VX7FAR/Servo-Tester/CAD/enclosure.step

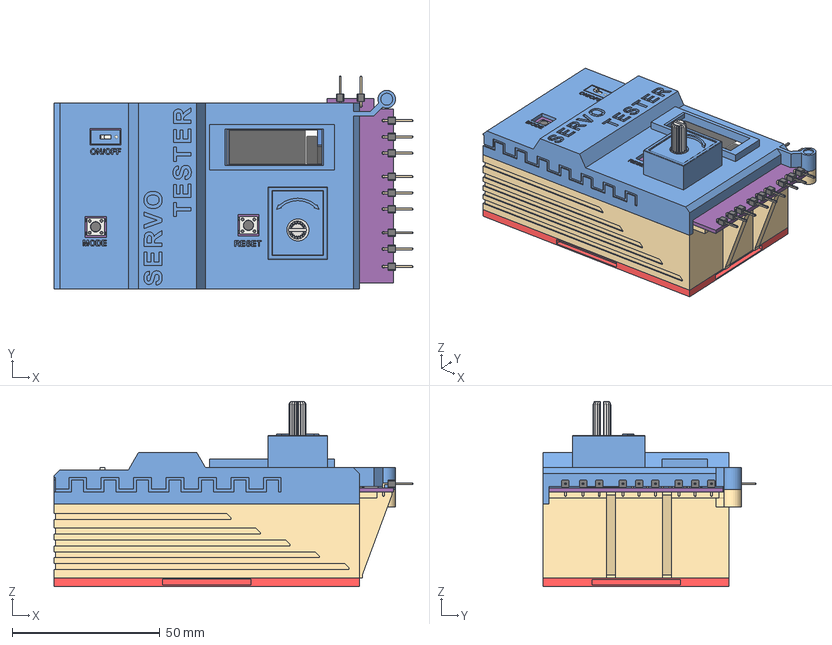
[picture p7: CAD file, 2026-10-06]
CAD/enclosure.step
121.7 x 72.0 x 62.8 mm
PinHeader_1x01_P254mm_Horizontal x 11
Arduino Nano_1
shaft
ScrewBase
Board
Pin1
Pin2
Pin3
casing
D_A-405_P10.16mm_Horizontal_2 x 2
SW_PUSH_6mm_2 x 2
OLED_0.91_128x32_2
Pin Header 4 x 1 TH 2.54mm Pitch
RESC-0603 x 13
2SD0601A
SW_DIP_SPSTx01_Slide_978x472mm_W762mm_P254mm
serC964_PCB
