VX7FAR/Servo-Tester/PCB/servo tester.step

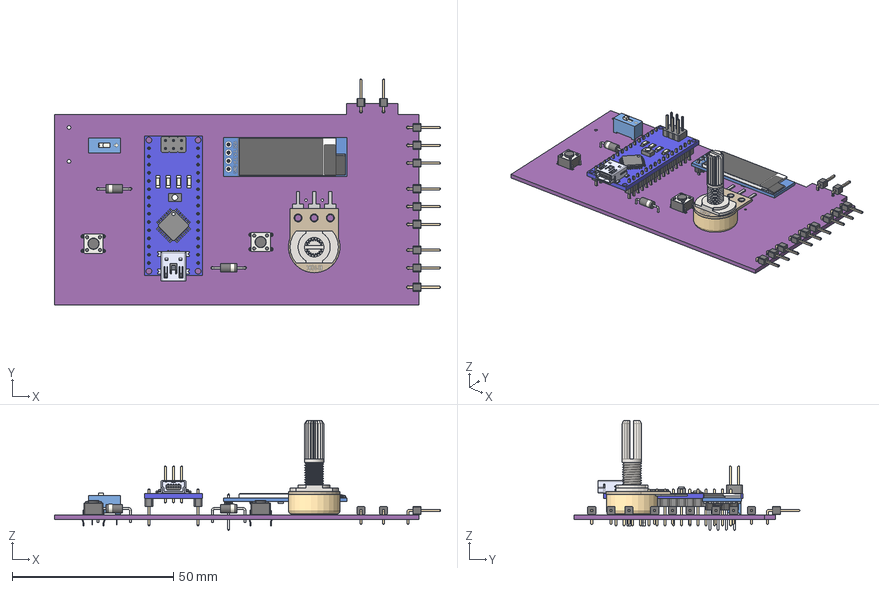
[picture p8: CAD file, 2026-09-28]
PCB/servo tester.step
119.7 x 70.0 x 34.1 mm
PinHeader_1x01_P254mm_Horizontal x 11
Arduino Nano
Shaft
ScrewBase
Board
Pin1
Pin2
Pin3
Casing
D_A-405_P10.16mm_Horizontal x 2
SW_PUSH_6mm x 2
OLED_0.91_128x32
Pin Header 4 x 1 TH 2.54mm Pitch
RESC-0603 x 13
2SD0601A
SW_DIP_SPSTx01_Slide_978x472mm_W762mm_P254mm
serC964_PCB
