VX7FAR/Servo-Tester/assets/Arduino Nano.STEP

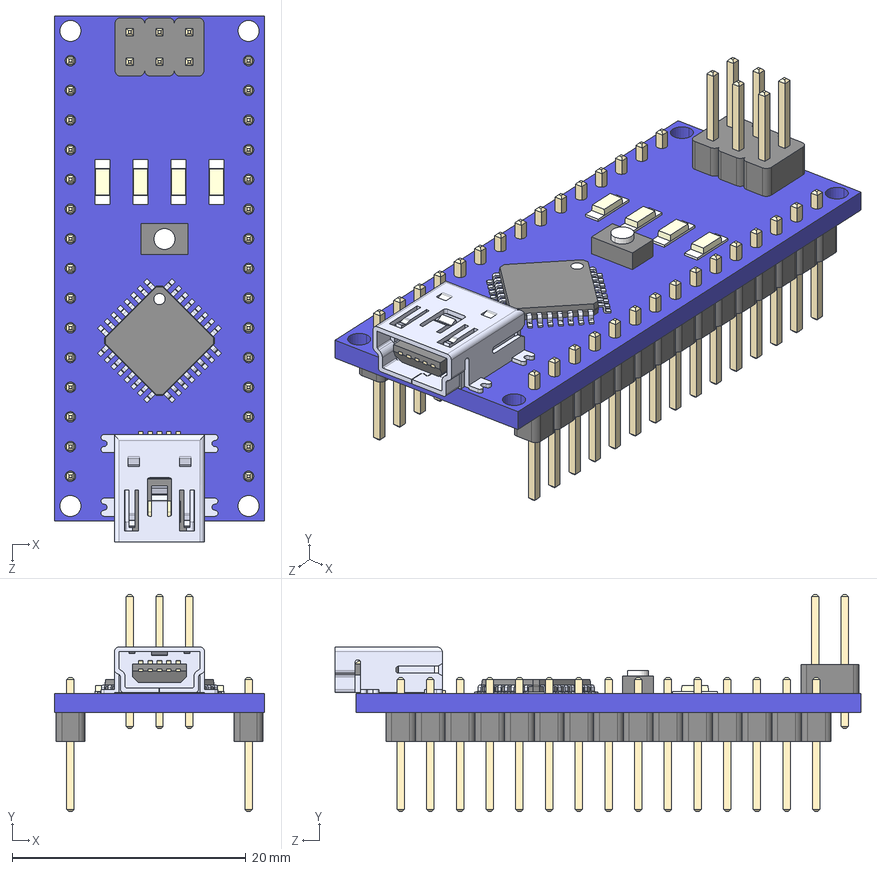
[picture p9: CAD file, 2026-09-20]
assets/Arduino Nano.STEP
18.0 x 18.6 x 45.0 mm
