VX7FAR/Servo-Tester/CAD/PANEL.step

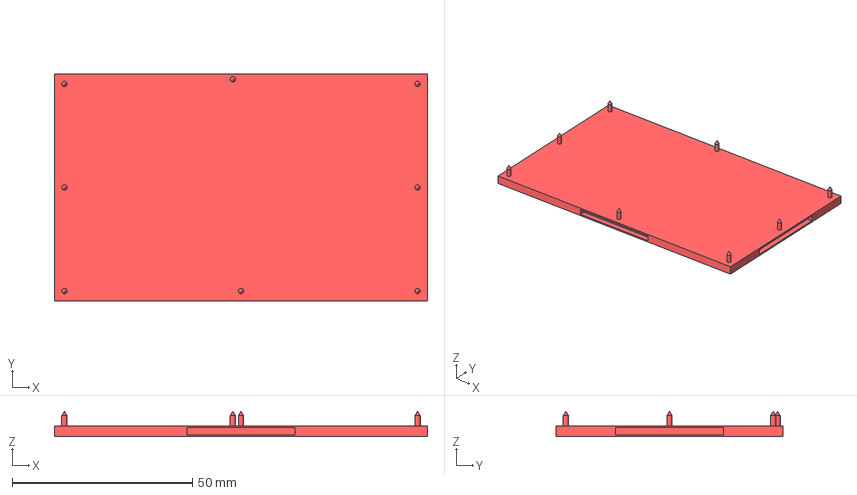
[picture p10: CAD file, 2026-09-28]
CAD/PANEL.step
103.5 x 63.0 x 7.00 mm
