VX7FAR/Servo-Tester/assets/PotentiometerB10K.step

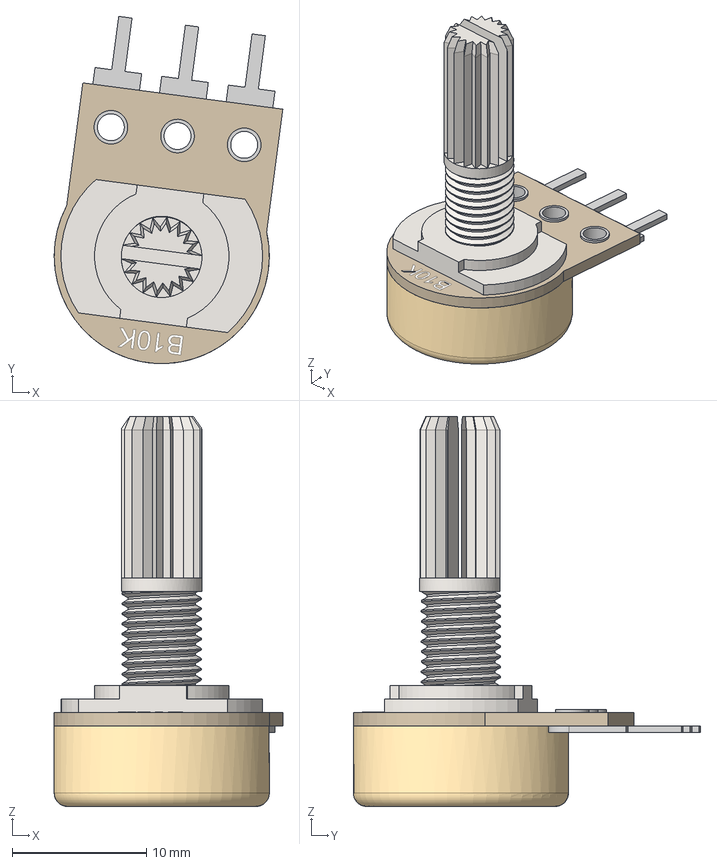
[picture p11: CAD file, 2026-09-20]
assets/PotentiometerB10K.step
17.0 x 25.8 x 29.0 mm
Shaft
ScrewBase
Board
Pin1
Pin2
Pin3
Casing
