VX7FAR/Servo-Tester/CAD/BOTTOM.step

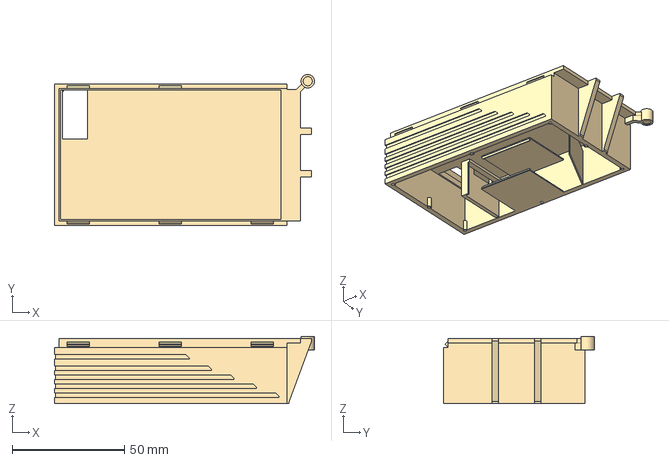
[picture p12: CAD file, 2026-09-28]
CAD/BOTTOM.step
115.8 x 67.3 x 30.0 mm
