VX7FAR/Servo-Tester/CAD/TOP.step

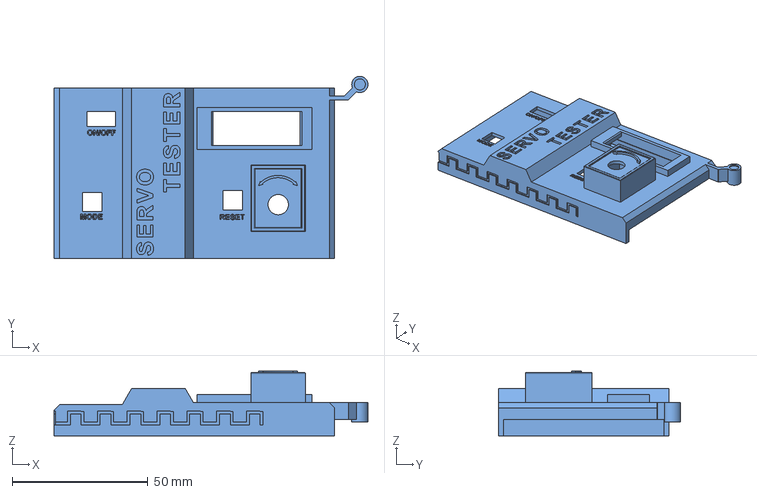
[picture p13: CAD file, 2026-09-28]
CAD/TOP.step
115.8 x 67.3 x 23.8 mm
