VX7FAR/Servo-Tester/(list of files, cad)

Other CAD files:
CAD/enclosure.f3z
