VX7FAR/Servo-Tester/PCB/servo tester.kicad_pcb

## KiCad design PCB/servo tester.kicad_pcb (2026-09-28)

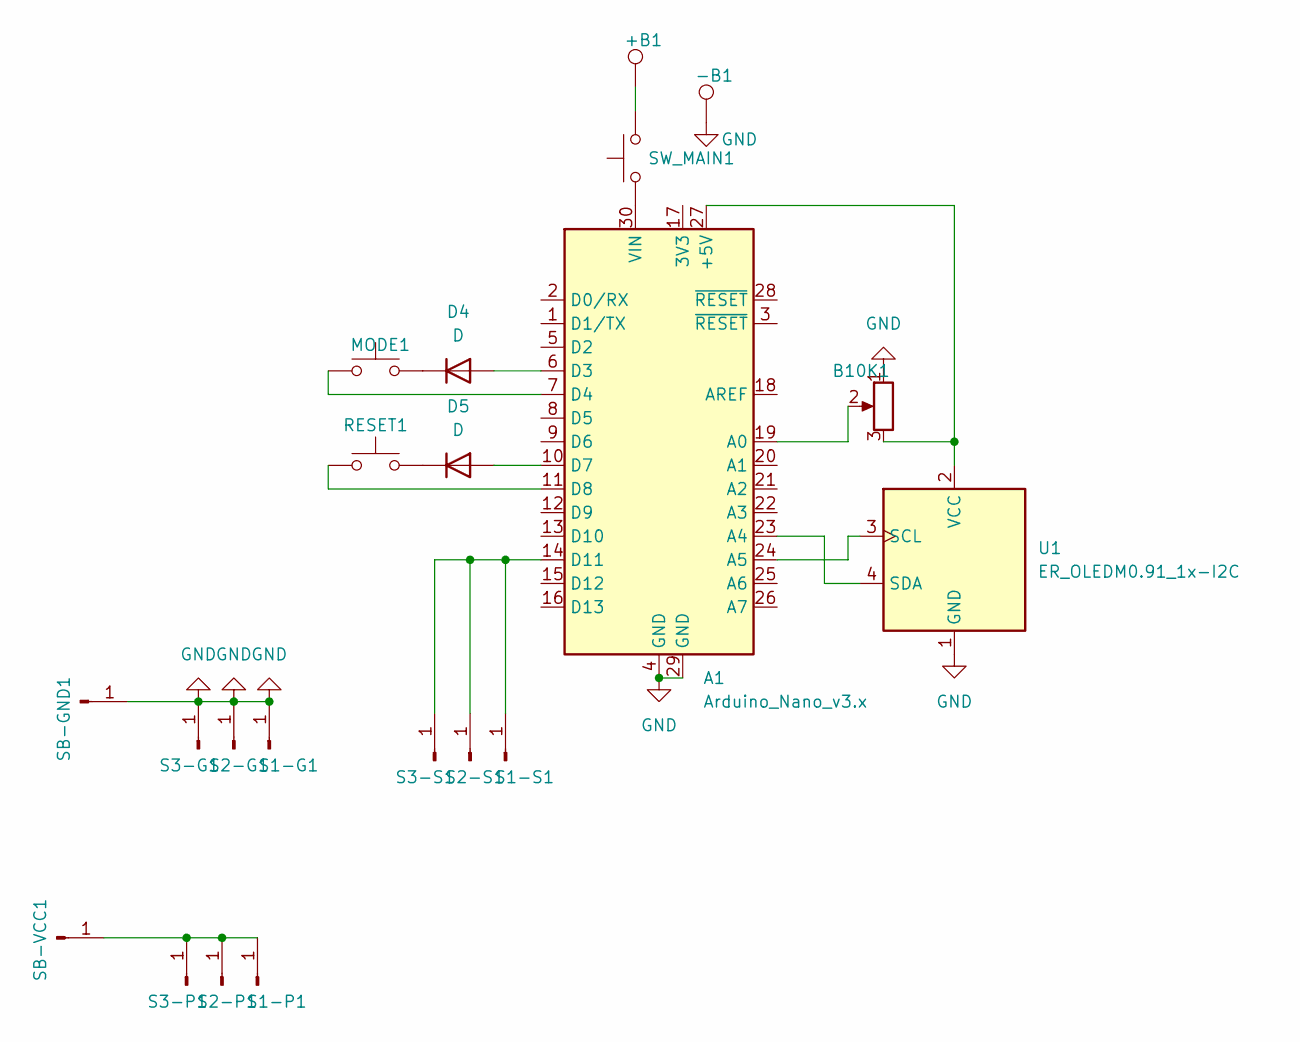
[picture p14: schematic servo tester.kicad_sch]

Parts:
+B1: TestPoint; SolderWire-0.5sqmm_1x01_D0.9mm_OD2.1mm
-B1: TestPoint; SolderWire-0.5sqmm_1x01_D0.9mm_OD2.1mm
A1: Arduino_Nano_v3.x; Arduino_Nano
B10K1: R_Potentiometer; Potentiometer_Bourns_3386C_Horizontal
D4, D5: D; D_A-405_P10.16mm_Horizontal
MODE1: SW_Push; SW_PUSH_6mm
RESET1: SW_Push; SW_PUSH_6mm
S1-G1, S1-P1, S1-S1, S2-G1, S2-P1, S2-S1, S3-G1, S3-P1, S3-S1: Conn_01x01_Pin; PinHeader_1x01_P2.54mm_Horizontal
SB-GND1: Conn_01x01_Pin; PinHeader_1x01_P2.54mm_Horizontal
SB-VCC1: Conn_01x01_Pin; PinHeader_1x01_P2.54mm_Horizontal
SW_MAIN1: SW_Push; SW_DIP_SPSTx01_Slide_9.78x4.72mm_W7.62mm_P2.54mm
U1: ER_OLEDM0.91_1x-I2C

Connections:
GND: -B1.1 (1_1), A1.4 (GND), A1.29 (GND), B10K1.1, S1-G1.1 (Pin_1_1), S2-G1.1 (Pin_1_1), S3-G1.1 (Pin_1_1), SB-GND1.1 (Pin_1_1), U1.1 (GND)
unnamed: +B1.1 (1_1), SW_MAIN1.2
unnamed: A1.27 (+5V), B10K1.3, U1.2 (VCC)
unnamed: A1.19 (A0), B10K1.2
unnamed: A1.23 (A4), U1.4 (SDA)
unnamed: A1.24 (A5), U1.3 (SCL)
unnamed: A1.6 (D3), D4.2 (A)
unnamed: A1.7 (D4), MODE1.1
unnamed: A1.10 (D7), D5.2 (A)
unnamed: A1.11 (D8), RESET1.1
unnamed: A1.14 (D11), S1-S1.1 (Pin_1_1), S2-S1.1 (Pin_1_1), S3-S1.1 (Pin_1_1)
unnamed: A1.30 (VIN), SW_MAIN1.1
unnamed: D4.1 (K), MODE1.2
unnamed: D5.1 (K), RESET1.2
unnamed: S1-P1.1 (Pin_1_1), S2-P1.1 (Pin_1_1), S3-P1.1 (Pin_1_1), SB-VCC1.1 (Pin_1_1)

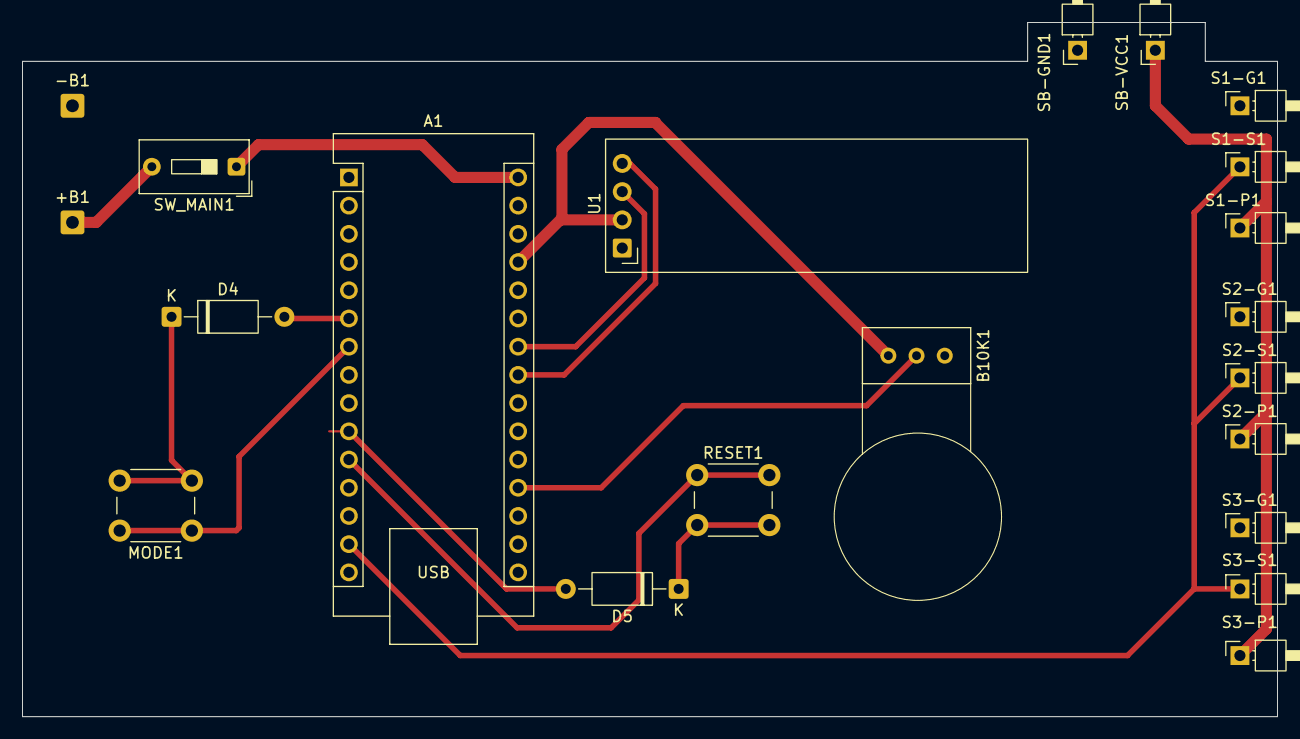
[picture p15: board servo tester.kicad_pcb from above]

Board: 2 copper layers, 113.0 x 62.5 mm, 21 parts (0 on the bottom side), 15 nets.
