VX7FAR/Servo-Tester/(commit log)

2026-09-18 done a quite a bit of PCB
    [servo tester.kicad_pcb, servo tester.kicad_sch]
2026-09-20 redid pcb
    [Arduino Nano.STEP, OLED.STEP, PCB3D.step, PotentiometerB10K.step, servo tester.kicad_pcb, servo tester.kicad_sch]
2026-09-25 finsihed cad
    [MIDDLE BOX.stl, PANEL.stl, PCB3D.step, TOP.stl, servo tester.kicad_pcb, servo tester.kicad_sch]
2026-09-28 almost ship ready
    [Arduino Nano.STEP, BOTTOM.step, MIDDLE BOX.stl, OLED.STEP, OLED_0.91_128x32.stp, PANEL.step, PANEL.stl, PCB3D.step]
2026-09-28 bom and small potato stuff
    [BOM.csv, enclosure.f3z]
2026-09-28 ready for funding
    [BOM.csv]
2026-09-28 ready for funding...again....again
    [BOM.csv]
2026-09-29 added items to bom
    [BOM.csv]
2026-10-01 updated bom
    [BOM.csv]
2026-10-06 added enclosure step
    [BOM.csv, enclosure.step]
